sujan101315/Final-Year-Project-B.Tech-/Sch_PCB/3D_Assembly.JPG

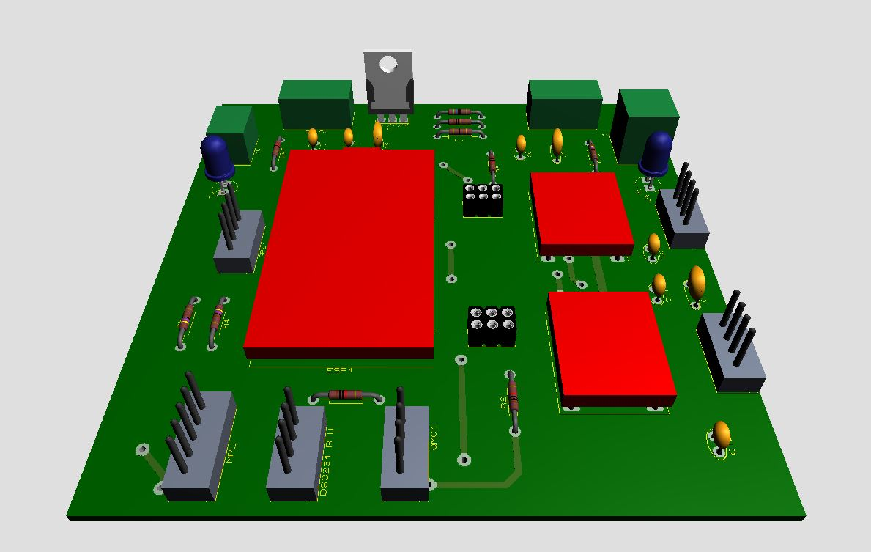
Sch_PCB/3D_Assembly.JPG
