sujan101315/Final-Year-Project-B.Tech-/Sch_PCB/PCB_Design.JPG

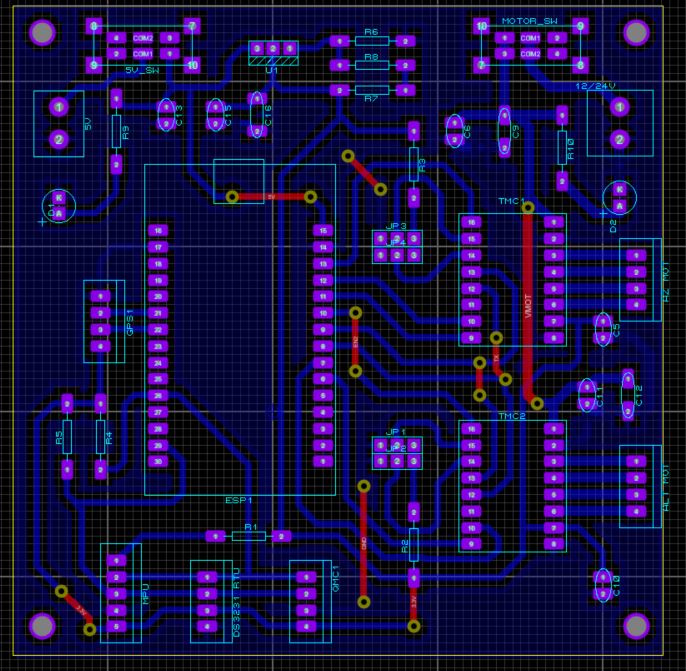
Sch_PCB/PCB_Design.JPG
