sujan101315/Final-Year-Project-B.Tech-/README.md

🔭 Digitization of an 8-inch Dobsonian Telescope

📌 Overview
This project aims to convert a manual 8-inch Dobsonian telescope into a fully automated Go-To and tracking telescope using ESP32. The system is designed for celestial object tracking, solar observation, and astrophotography.

✨ Features

•	Automatic celestial object tracking 
•	Dual-axis stepper motor control 
•	GPS-based location detection 
•	Real-time clock (RTC) synchronization 
•	MPU9250 orientation sensing 
•	Magnetometer-assisted alignment 
•	Solar tracking mode 
•	Future integration with JPL Horizons database 

🛠 Hardware Used

•	ESP32 
•	NEMA Stepper Motors 
•	Stepper Motor Drivers 
•	MPU9250 IMU 
•	GPS Module 
•	RTC Module 
•	Power Supply 
•	8-inch Dobsonian Telescope 

💻 Software

•	Arduino IDE 
•	C++ 
•	ESP32 Framework 

📂 Project Structure

•	Hardware 
•	Firmware 
•	CAD Files 
•	Documentation 
•	Images 

🚀 Future Improvements

•	Wi-Fi/Web Control 
•	Mobile App 
•	Automatic Star Alignment 
•	Deep Sky Object Database 

📸 Project Images
