sujan101315/Final-Year-Project-B.Tech-/Sch_PCB/PCB_Layout.pdf

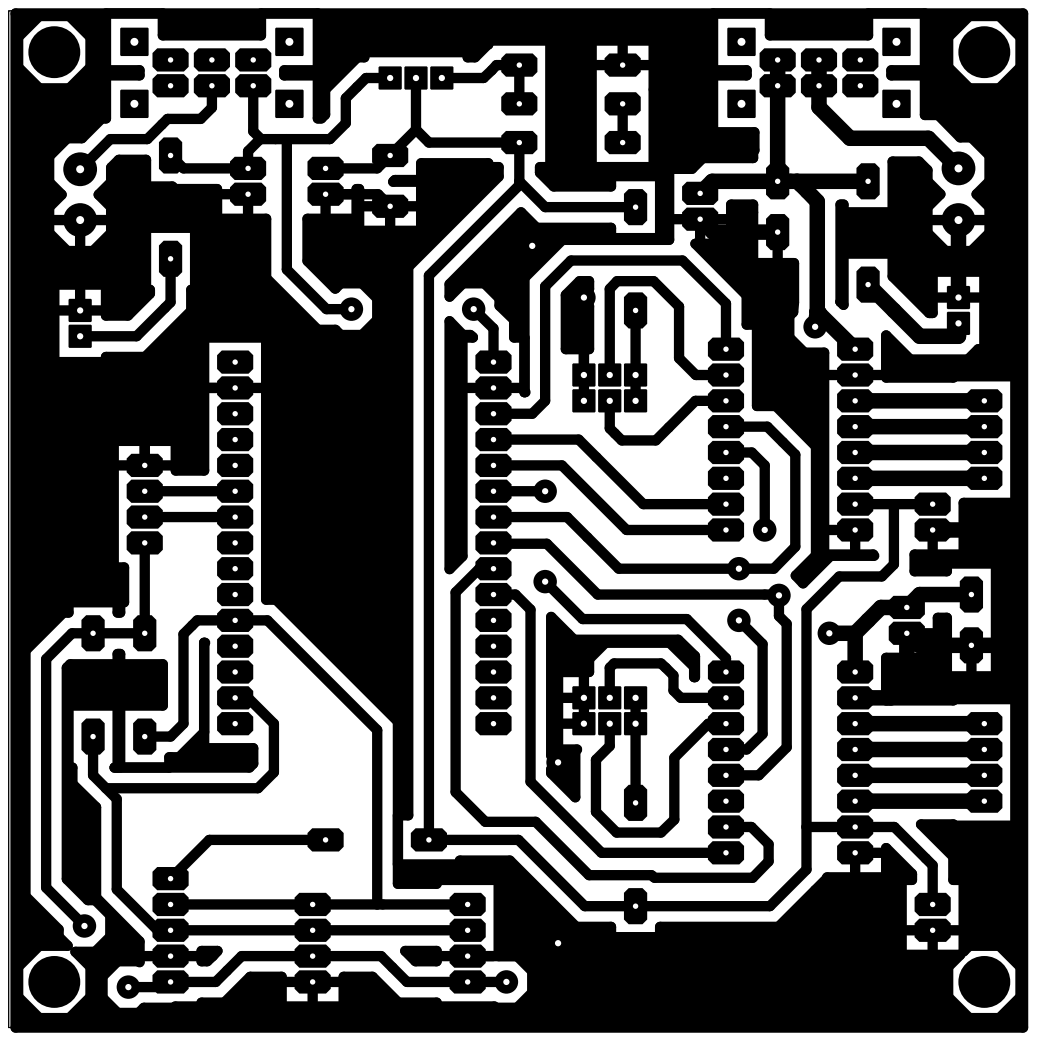
[picture p37: page 1]
