sujan101315/Final-Year-Project-B.Tech-/(list of files, drawings)

Other design files:
Star_Tracking_System.pdsprj
